ji5h/COMP207-Micromouse/CAD/Render and Drawing Files/Fred Assembly.png

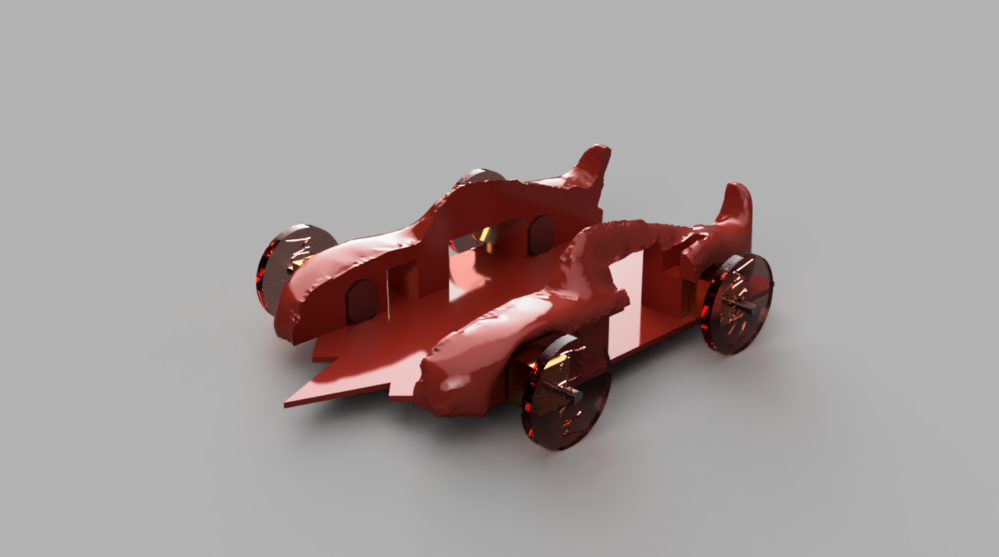
CAD/Render and Drawing Files/Fred Assembly.png
