ji5h/COMP207-Micromouse/README.md

# COMP207 - Micromouse project (Digital Prototyping)

## Project description

In this project I explore many different types of digital prototyping techniques and apply them to create a micromouse that could compete in the micromouse competion.
