ji5h/COMP207-Micromouse/Electronics/README.md

# Electronics

Contains files for PCB design.
