ji5h/COMP207-Micromouse/CAD/README.md

# CAD files 

Contains fusion files, renders and drawings.
