ji5h/COMP207-Micromouse/Documentation/COMP207 - Development Log af4a81f1a4c44aa8a1bae7b86fbc5e3a/72382275800__F4054668-2B92-4F0E-B3C7-8FC2BBE17B63.jpeg

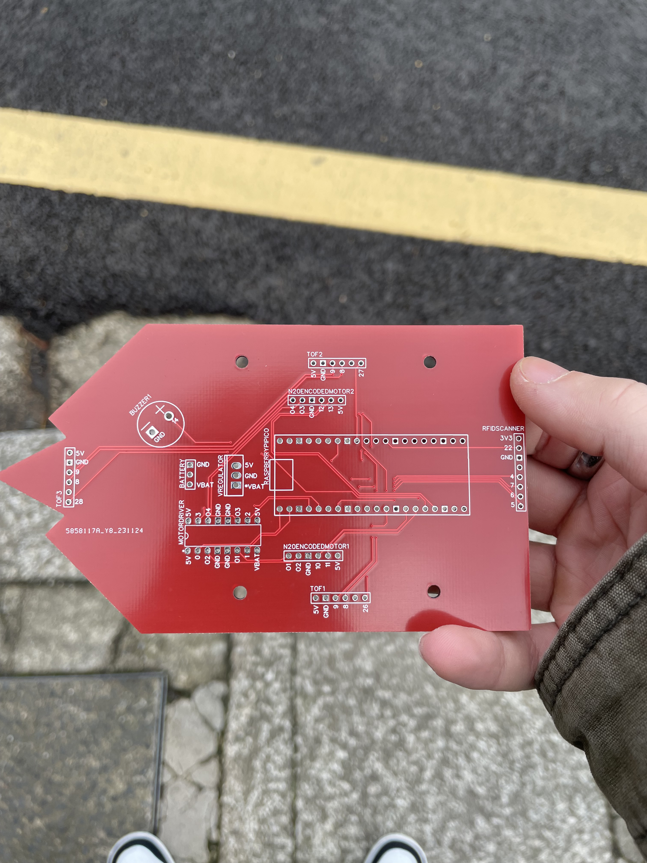
Documentation/COMP207 - Development Log af4a81f1a4c44aa8a1bae7b86fbc5e3a/72382275800__F4054668-2B92-4F0E-B3C7-8FC2BBE17B63.jpeg
