ji5h/COMP207-Micromouse/Documentation/COMP207 - Development Log af4a81f1a4c44aa8a1bae7b86fbc5e3a/Added_Buzzer_to_PCB.png

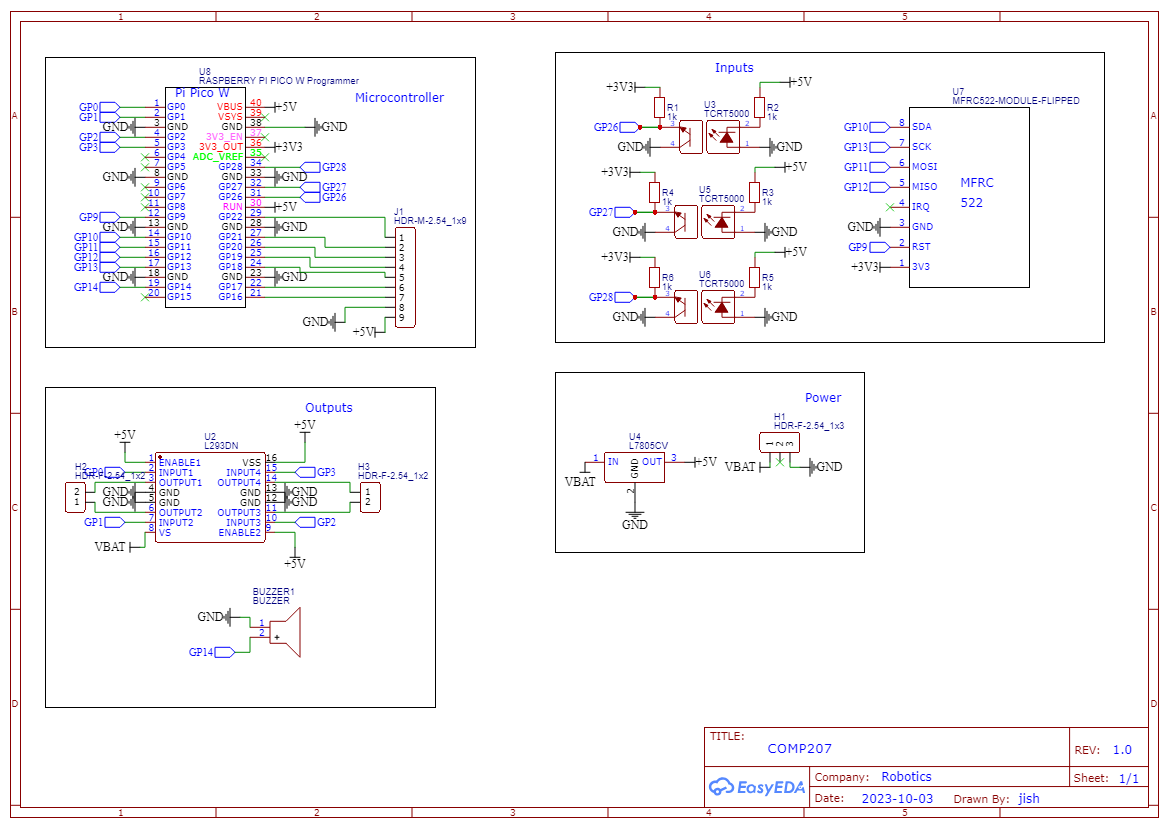
Documentation/COMP207 - Development Log af4a81f1a4c44aa8a1bae7b86fbc5e3a/Added_Buzzer_to_PCB.png
