ji5h/COMP207-Micromouse/Documentation/COMP207 - Development Log af4a81f1a4c44aa8a1bae7b86fbc5e3a/image_2023-10-11_135800101.png

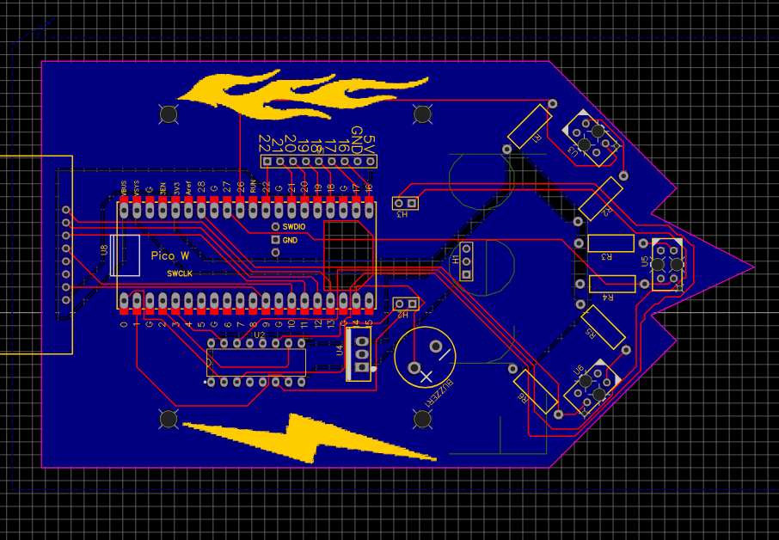
Documentation/COMP207 - Development Log af4a81f1a4c44aa8a1bae7b86fbc5e3a/image_2023-10-11_135800101.png
