ji5h/COMP207-Micromouse/media/Motor_mount_right_final_2024-Jan-27_02-53-11PM-000_CustomizedView915028378.png

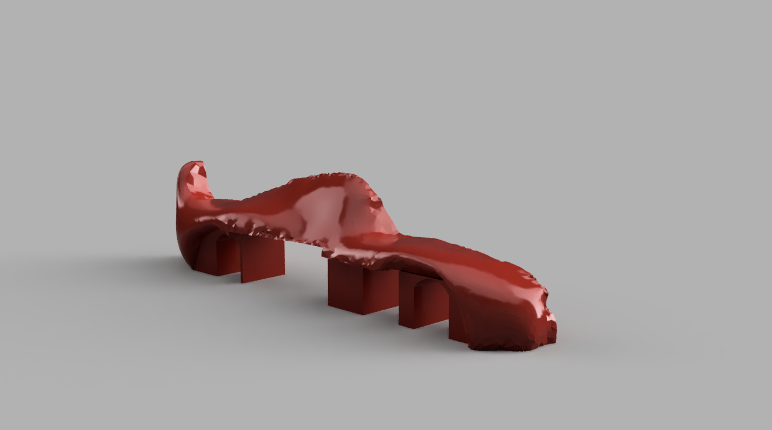
media/Motor_mount_right_final_2024-Jan-27_02-53-11PM-000_CustomizedView915028378.png
