ji5h/COMP207-Micromouse/Electronics/Iteration 2 PCB/BOM_PCB_COMP207_2_2024-01-26.csv

ID | Name | Designator | Footprint | Quantity | Manufacturer Part | Manufacturer | Supplier | Supplier Part | Price
1 | HDR-F-2.54_1x8 | RFIDSCANNER | HDR-F-2.54_1X8 | 1 |  |  | LCSC | C225505 | 0.196
2 | RASPBERRY PI PICO WITH 3D MODEL COPY | RASPBERRYPIPICO | RASPBERRY PI PICO/ RASPBERRY PI PICO W | 1
3 | HDR-F-2.54_1x3 | BATTERY | HDR-F-2.54_1X3 | 1 |  |  | LCSC | C146690 | 0.076
4 | BUZZER | BUZZER1 | BUZ-TH_BD12.0-P6.00-D0.9-RD | 1 | buzzer | null | LCSC | C9900014030
5 | L293DN | MOTORDRIVER | DIP-16_L19.2-W6.6-P2.54-LS7.6-BL | 1 | L293DN | HGSEMI | LCSC | C434590 | 1.418
6 | HDR-F-2.54_1x6 | N20ENCODEDMOTOR1,N20ENCODEDMOTOR2,TOF1,TOF2,TOF3 | HDR-F-2.54_1X6 | 5 |  |  | LCSC | C40877 | 0.071
7 | L7805CV | VREGULATOR | TO-220-3_L10.0-W4.5-P2.54-L | 1 | L7805CV | ST(意法半导体) | LCSC | C111887 | 0.239
