ji5h/COMP207-Micromouse/(list of files, cad)

Other CAD files:
CAD/Fusion Files/Bottom Battery Holder v2.f3d
CAD/Fusion Files/Fred Assembly.f3z
CAD/Fusion Files/Motor mount test v1.f3d
CAD/Fusion Files/N20 Motor v3.f3d
CAD/Fusion Files/PCB (v2).f3d
CAD/Fusion Files/Stabalising scoop v5.f3d
CAD/Fusion Files/Top Battery Holder v2.f3z
CAD/Fusion Files/Wheel v1.f3d
CAD/Fusion Files/Wheel v16.f3d
