ji5h/COMP207-Micromouse/CAD/Render and Drawing Files/Assembly 3 Diagram v1.pdf

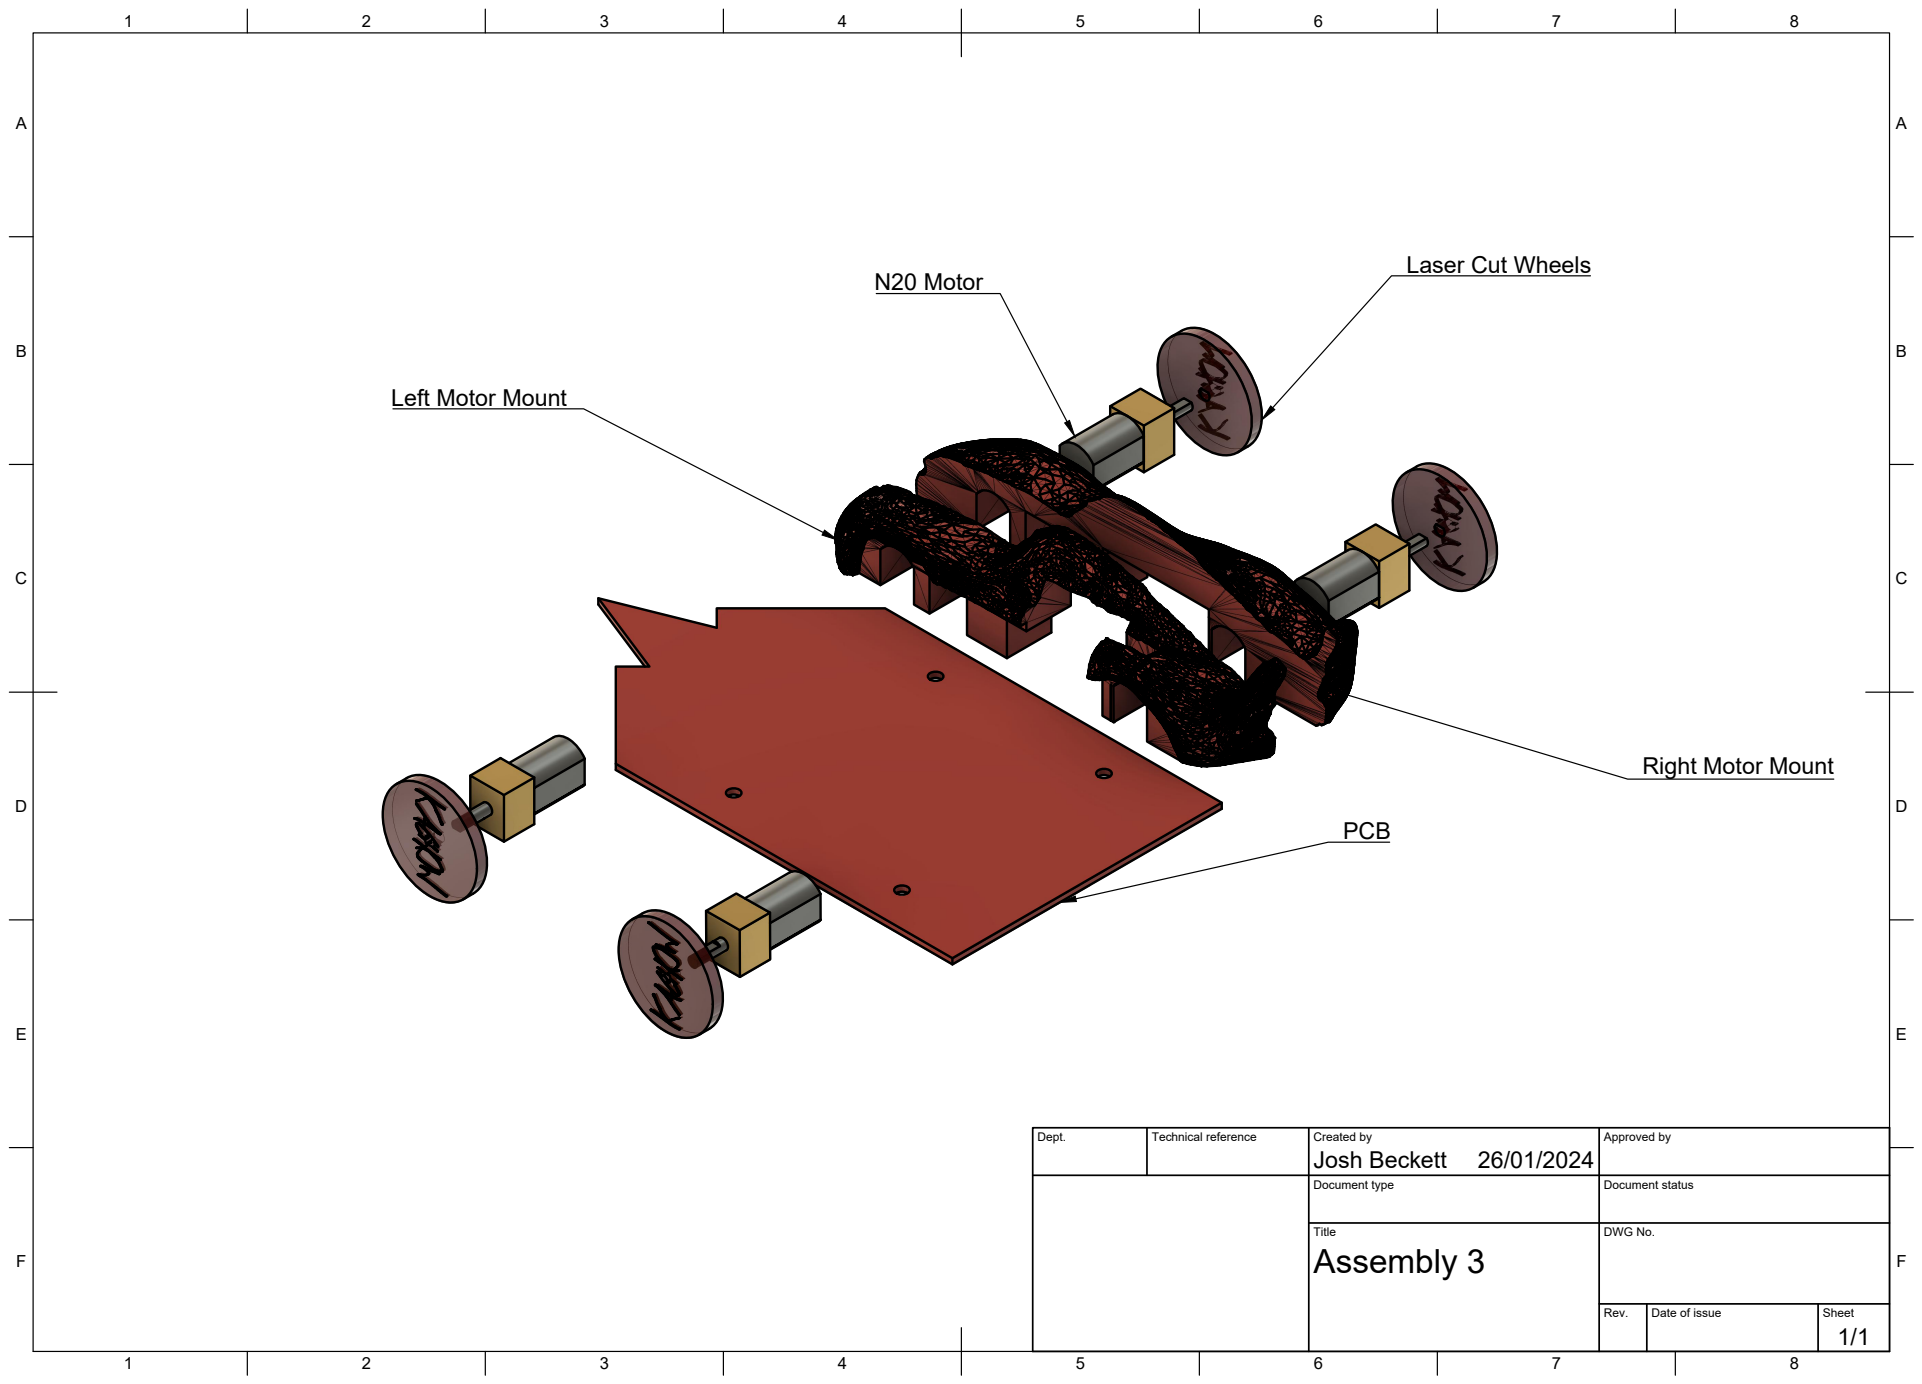
[picture p43: page 1]
Dept.; Technical reference; Created by; Approved by; Document type; Document status; Title; DWG No.; Rev.; Date of issue; Sheet; Assembly 3; Josh Beckett; N20 Motor

Laser Cut Wheels

Left Motor Mount

Right Motor Mount
