ji5h/COMP207-Micromouse/Electronics/Iteration 2 PCB/Schematic_COMP207_2024-01-26.pdf

## Microcontroller

## Inputs

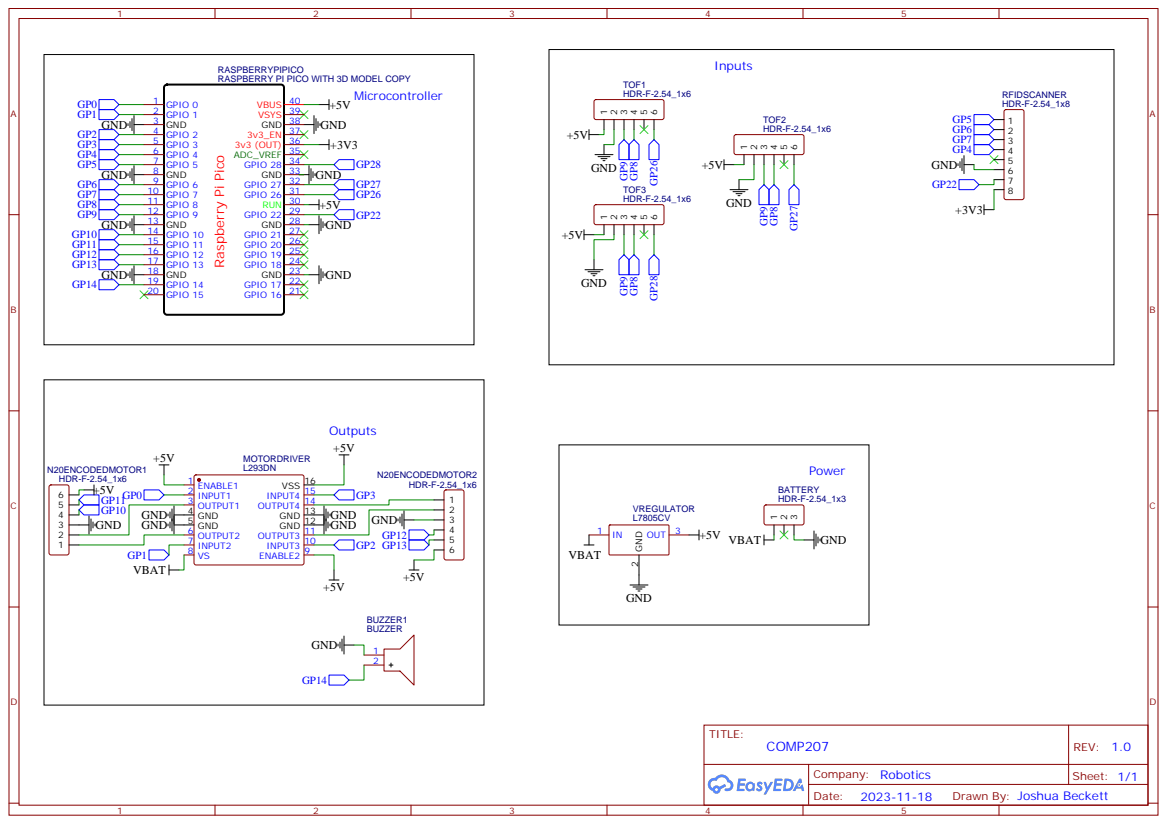
[picture p44: page 1]

RASPBERRYPIPICO
RASPBERRY PI PICO WITH 3D MODEL COPY

Drawn By: Joshua Beckett
