ji5h/COMP207-Micromouse/CAD/Render and Drawing Files/N20 Motor Drawing v1.pdf

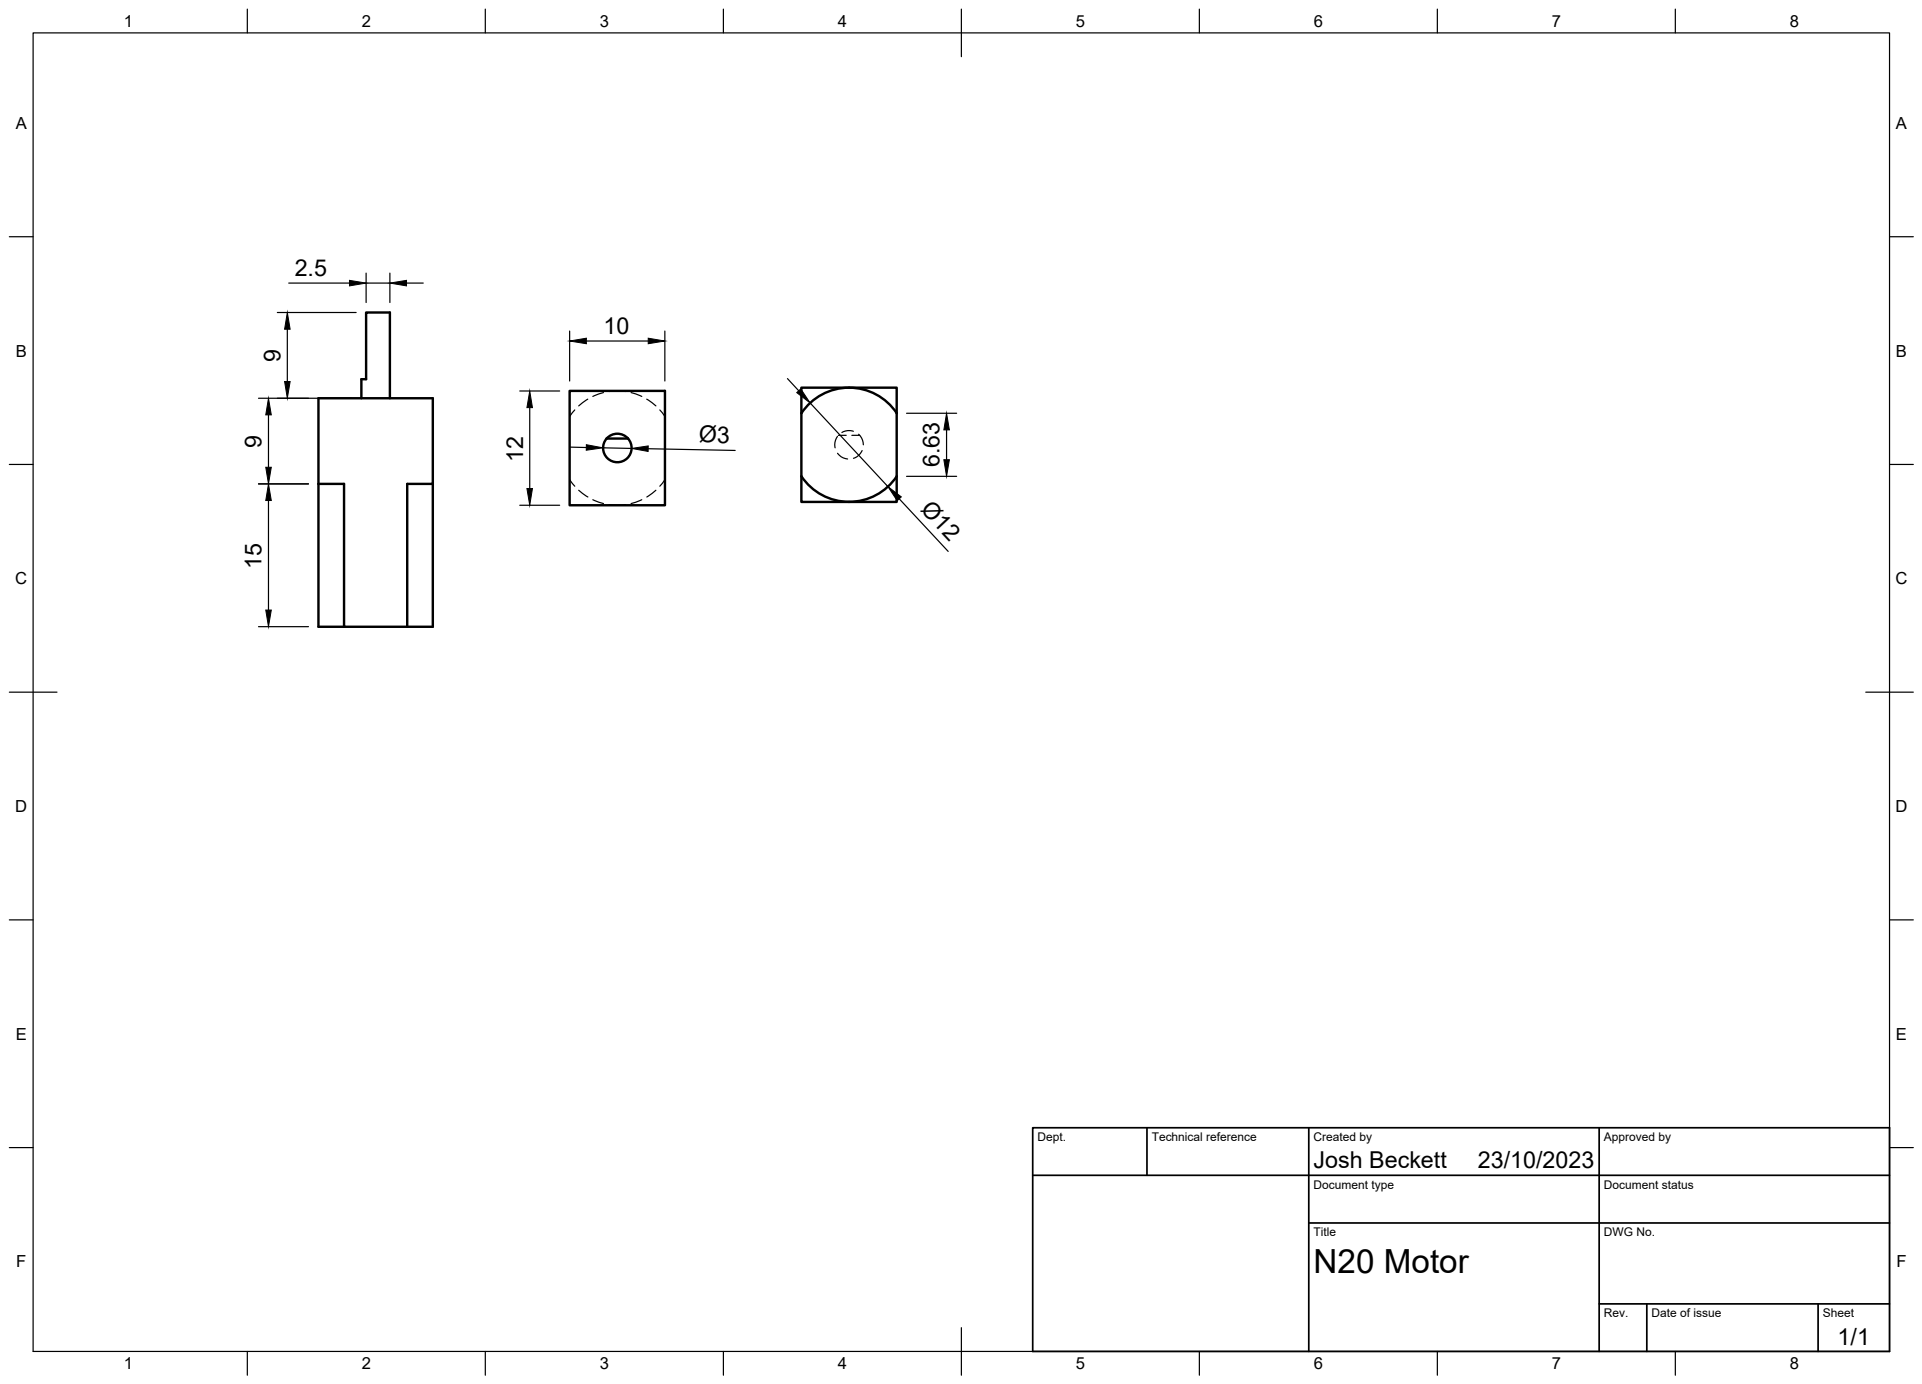
[picture p45: page 1]
Title; DWG No.; Rev.; Date of issue; Sheet; N20 Motor

Dept. | Technical reference | Created by Josh Beckett 23/10/2023 | Approved by

Document type | Document status
