ji5h/COMP207-Micromouse/Electronics/Iteration 2 PCB/PCB_PCB_COMP207_2_2024-01-26.pdf

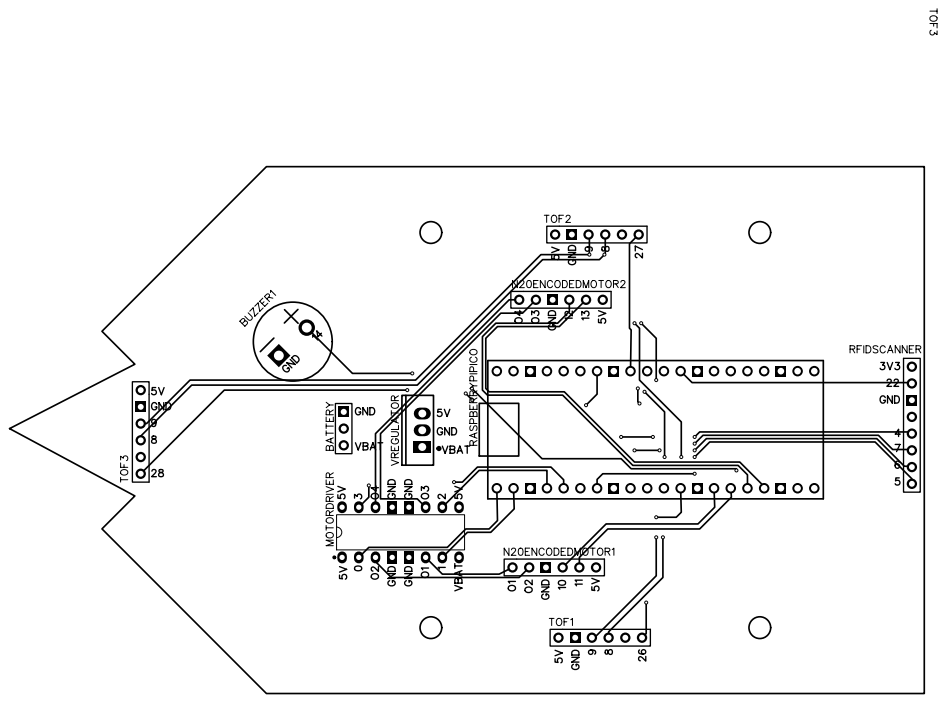
[picture p46: page 1]
