ji5h/COMP207-Micromouse/CAD/Render and Drawing Files/PCB Drawing v1.pdf

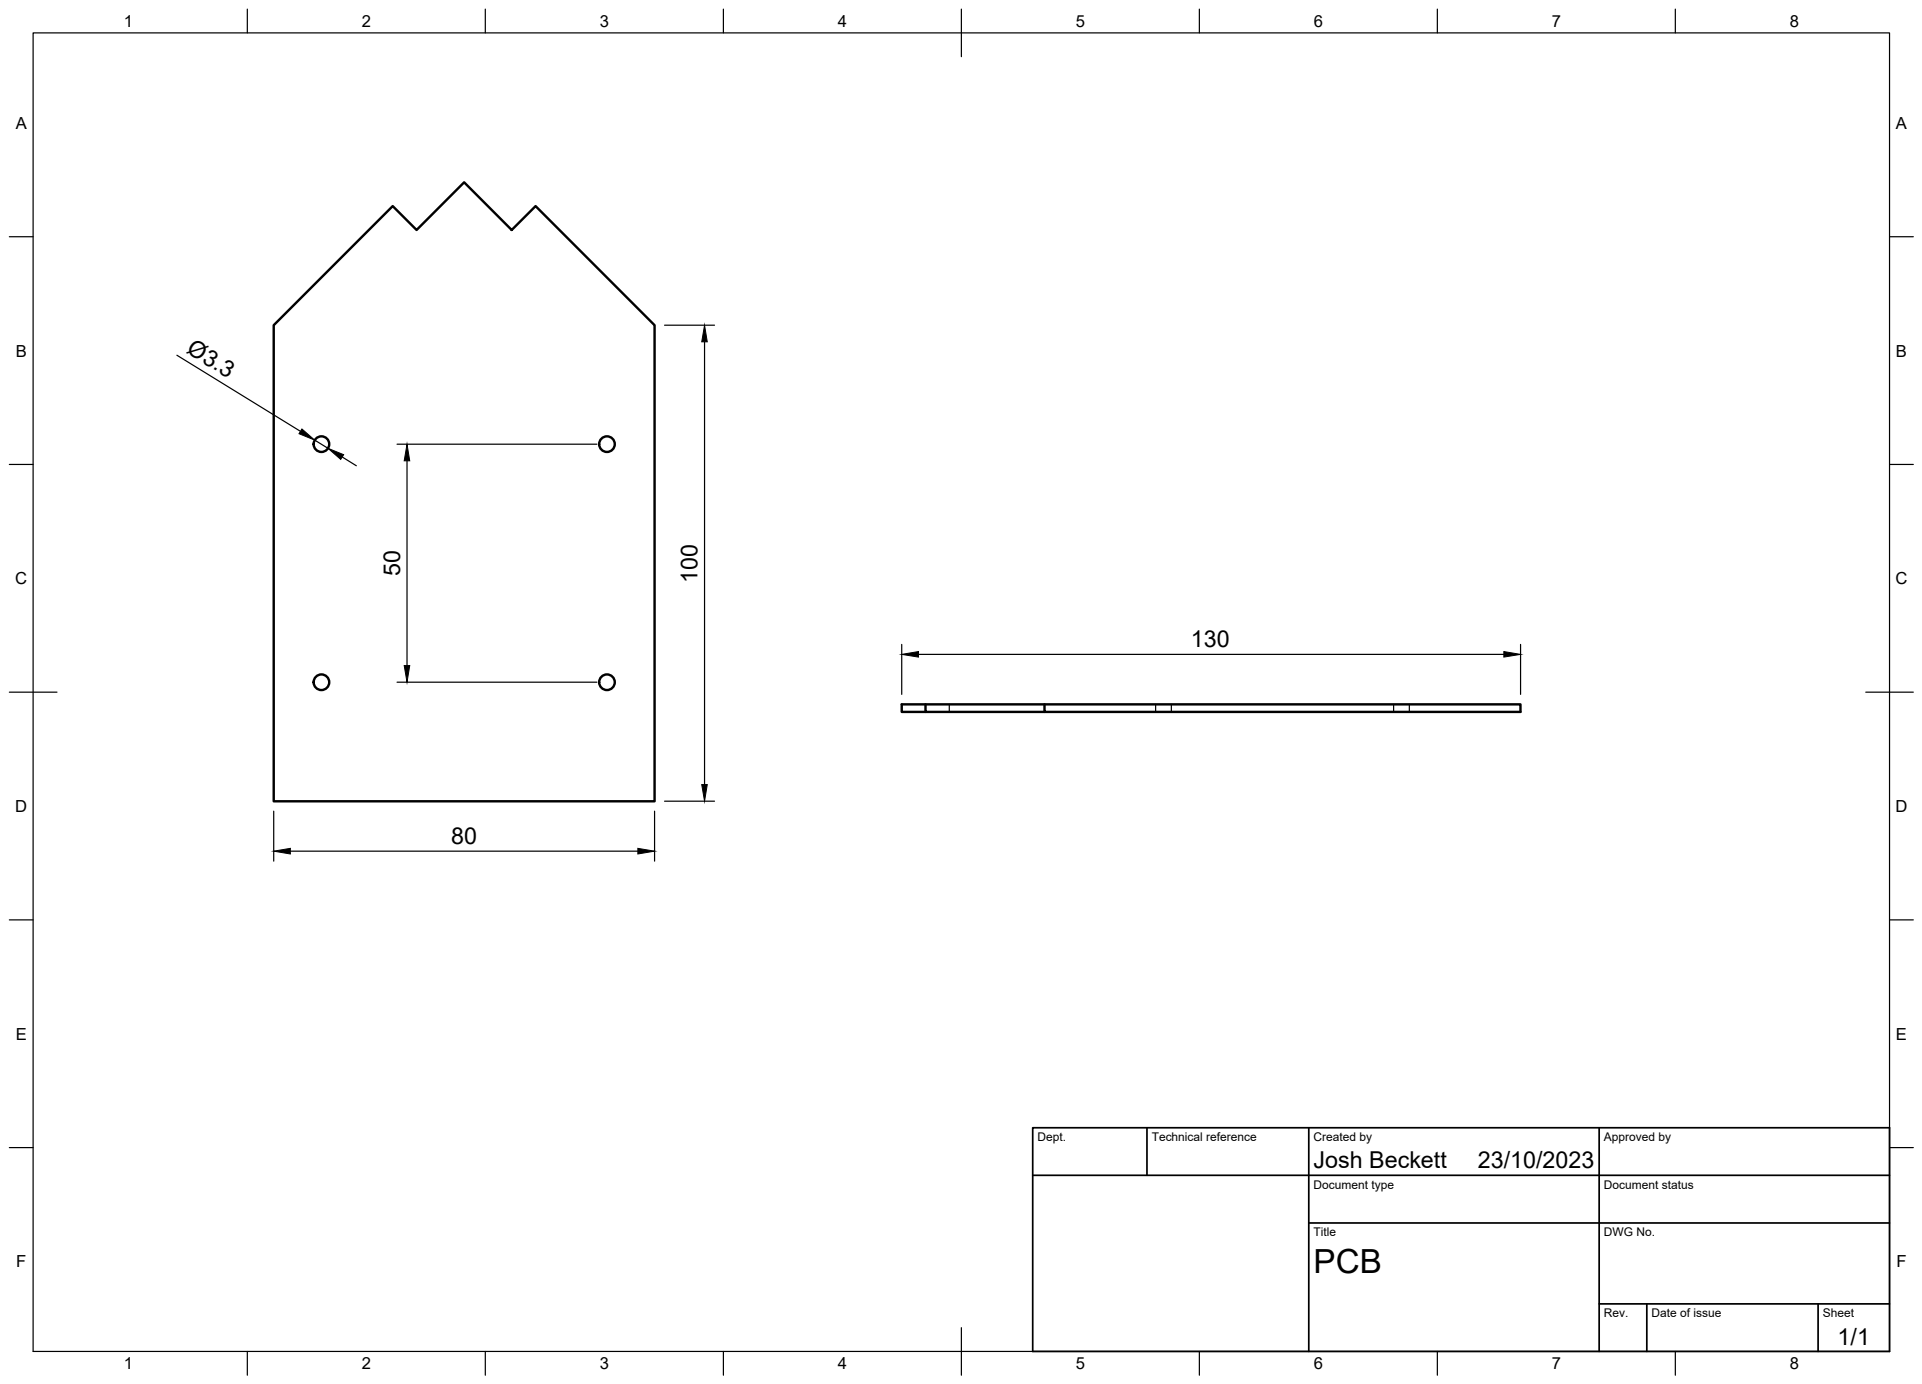
[picture p47: page 1]
Title; DWG No.; Rev.; Date of issue; Sheet; Josh Beckett 100

Dept. | Technical reference | Created by 23/10/2023 | Approved by

Document type | Document status
