ji5h/COMP207-Micromouse/Electronics/Iteration 1 PCB/PCB_PCB_COMP207_2023-10-23.pdf

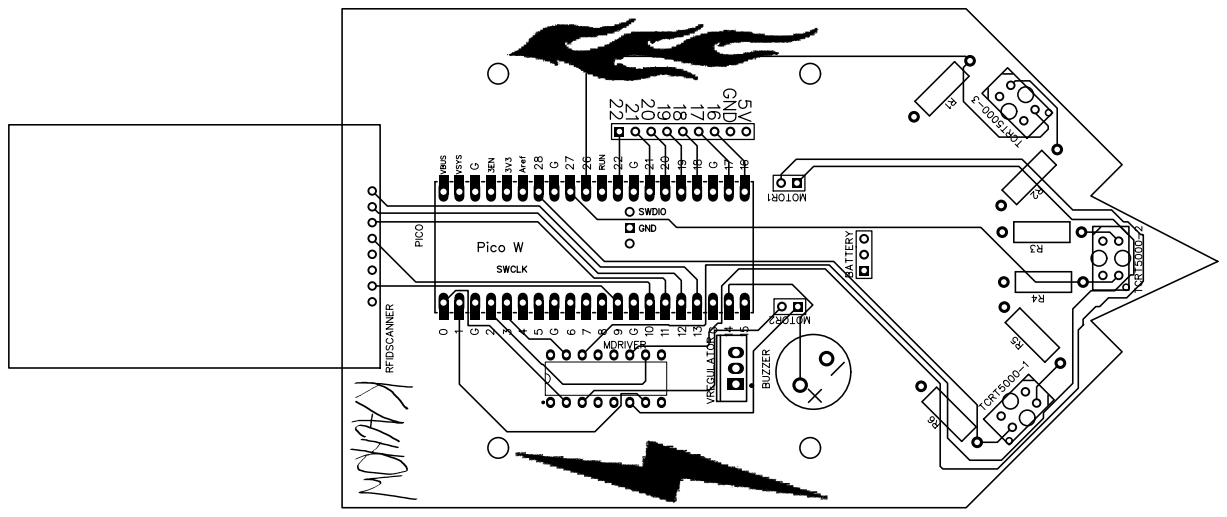
[picture p48: page 1]
