ji5h/COMP207-Micromouse/Electronics/Iteration 1 PCB/Schematic_COMP207_2023-10-23.pdf

## Microcontroller

## Inputs

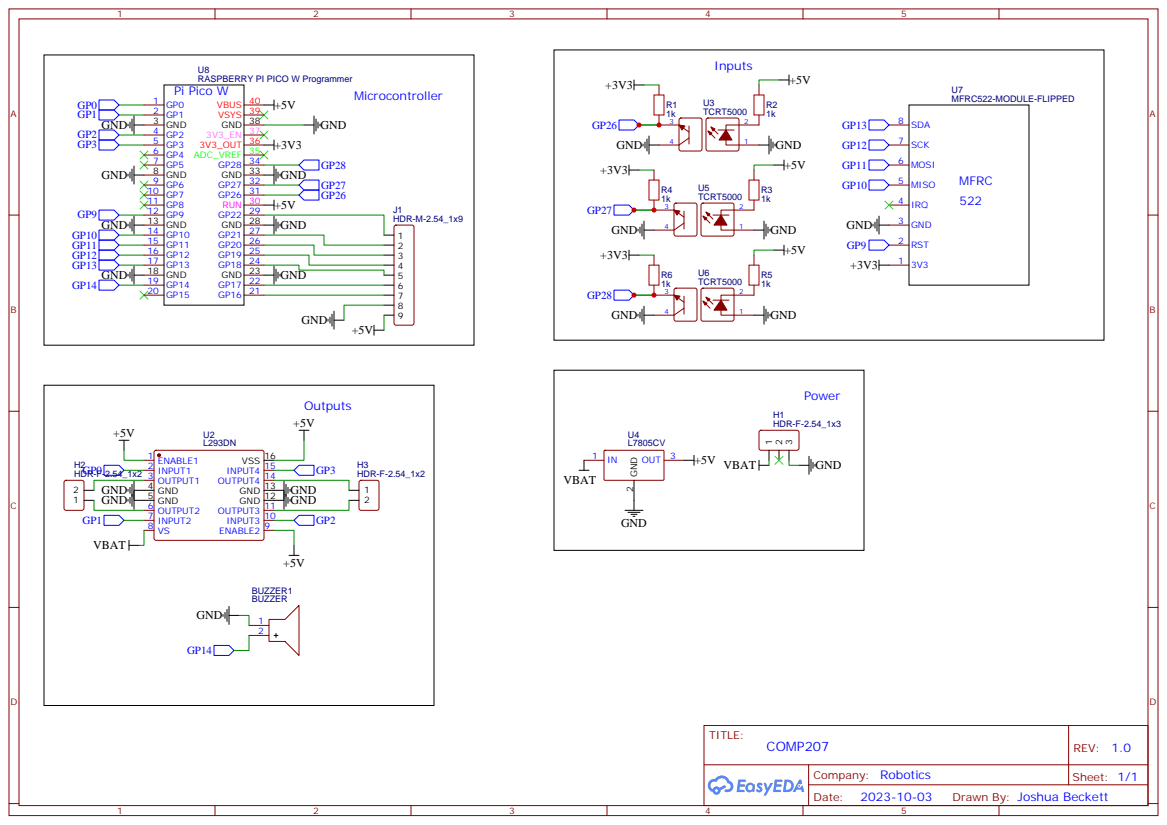
[picture p49: page 1]

Drawn By: Joshua Beckett
